DedeHai/RGBmatrix_6x6_Workshop/Photos/WS2812B_Detail.jpg

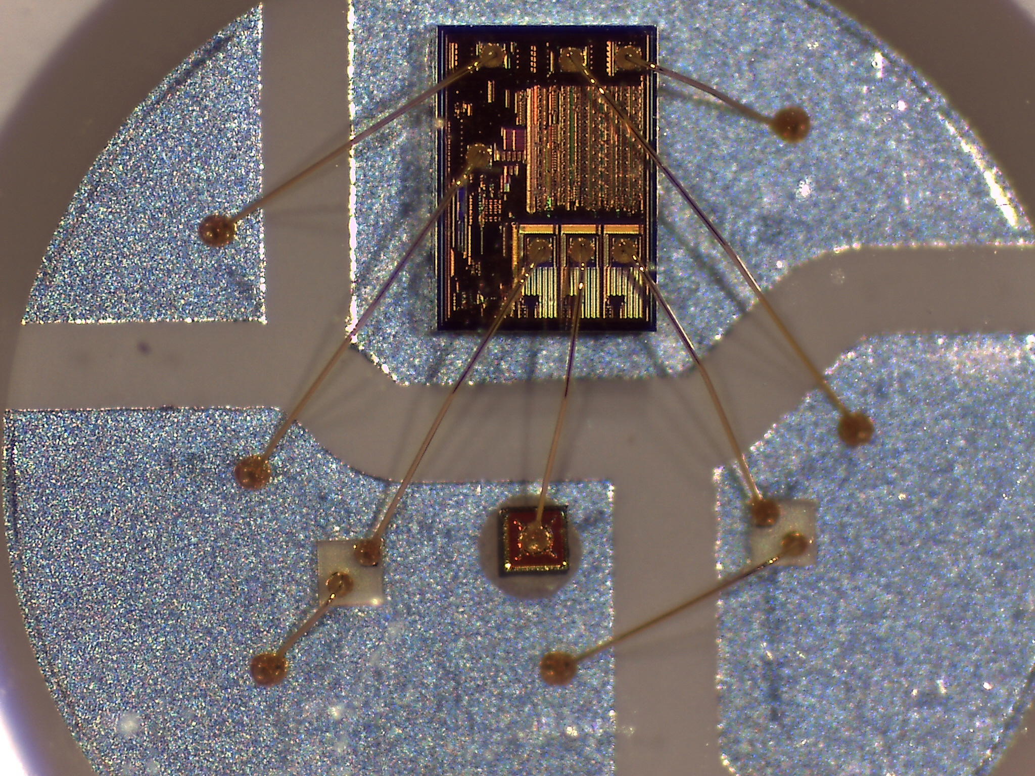
Photos/WS2812B_Detail.jpg
