DedeHai/RGBmatrix_6x6_Workshop/Photos/WS2812B_full.jpg

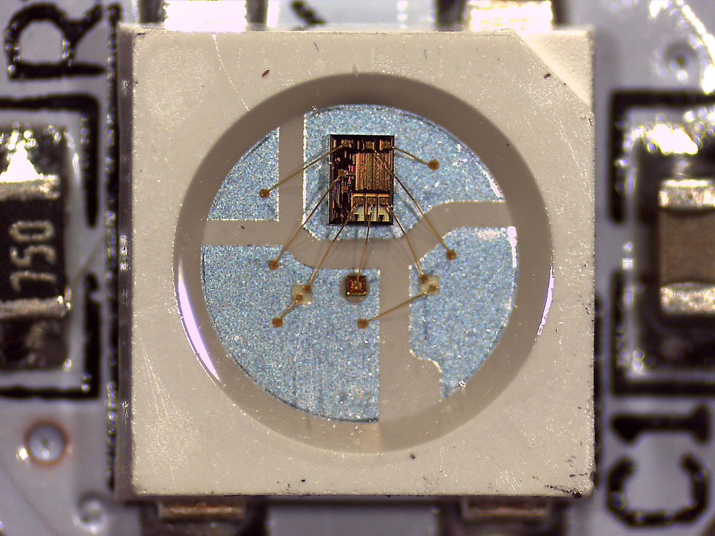
Photos/WS2812B_full.jpg
