DedeHai/RGBmatrix_6x6_Workshop/LED Panel Kurs Aufhänger mini.pdf

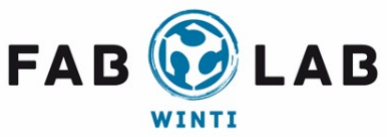
[picture p3: figure]

## Workshop: Bau von einer LED Matrix

Wir bieten dir in diesem Kurs die einmalige Gelegenheit ein LED Panel zu bauen, das von einem Arduino gesteuert wird. Diese moderne Lampe ist absolut einzigartig und ein garantierter Blickfang.
Auch für Anfänger geeignet.
Kosten inklusive 60.- Material: 195.- CHF/Person (Mitglieder 165.- CHF/Person) Anmelden unter www.fablabwinti.ch
