DedeHai/RGBmatrix_6x6_Workshop/LED Panel Workshop Anleitung.pdf

LED Panel Workshop Anleitung | Fablab Winterthur | Damian Schneider, 19. 4. 2015

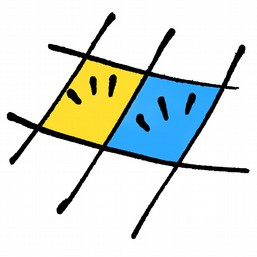
[picture p4: figure]

LED Panel Workshop - Bauanleitung

Materialliste
Netzteil: 5V 2A, Arduino Nano, Mini-USB Kabel, 2.1mm Steckerbuchse, Mikrofonmodul, RTC-modul, zwei Tasten, RIBBA Rahmen von Ikea, 36 LEDs (WS2812), Verbrauchsmaterial (Kabel, Pinheader, etc)
Raster vorbereiten
Nimm dir 14 Rasterleisten und schleife die Kanten der rauen Seite ganz leicht an, so dass sie etwas glatter wird. Manchmal sind die Kanten auch ohne schleifen schon OK. Steck die 14 Rasterleisten zusammen und lege es flach und rechtwinklig auf die Tischplatte. Was jetzt unten liegt wird nachher die Frontseite. Fixiere die Kreuzungen der Hauptdiagonalen sowie alle Kreuzungen auf der Aussenseite mit Weissleim. Nicht zu viel, wir wollen kein Leim der mehr als über die Mitte der Leisten nach unten läuft, das gibt sonst später ein Schatten im Bild. Leg das Raster zum trocknen zur Seite.

LED Platte vorbereiten

Zeichne mit einem Bleistift auf allen Seiten 14mm vom Rand der Platte eine Linie ein. Das ist das Aussenmass des Rasters.
Zeichne 6 senkrechte Linien, die erste mit 32mm Abstand zum Rand, die übrigen mit einem Abstand von jeweils 33mm voneinander (Tipp: die Rasterleisten sind im 33mm Abstand geschlitzt). Dasselbe nun in horizontaler Richtung.
Drehe die Platte so, dass die abgeschnittene Ecke Rechts unten liegt. Die sechs vertikalen Linien sind für die LED streifen. Markiere die Laufrichtung der LEDs mit Pfeilen, das erleichtert nachher das richtige Aufkleben. Zeichne unten bei der ersten Linie (die links) einen Pfeil nach oben, bei der zweiten nach unten, dritte nach oben usw.
Am oberen Ende: verbinde Linien 1&2 mit einem Bogen, dasselbe für 3&4 sowie 5&6. An diesen Stellen werden nachher Verbindungskabel gelötet.

Licensed under Creative Commons Attribution-NonCommercial-ShareAlike 4.0 International License

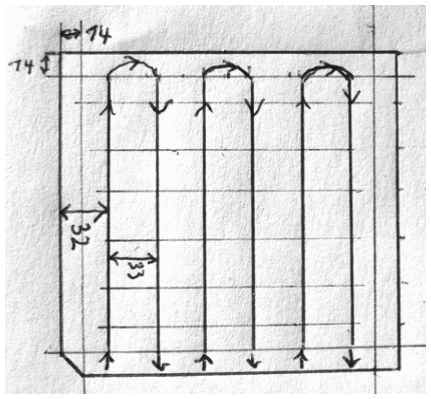
[picture p5: figure]

Zeit die LEDs aufzukleben.
Schneide mit dem Seitenschneider 6 LEDs vom Streifen ab. Markierte Schnittlinie benutzen. Lege (noch nicht kleben!) den streifen auf die Platte in korrekter Laufrichtung: die Pfeile auf der Platte müssen in dieselbe Richtung zeigen wie die Pfeile auf dem LED streifen. Mache das mit allen sechs Streifen. Prüfe nochmals die Laufrichtung. Schneide jetzt am unteren Ende der Streifen die Kupferaugen mittig durch (siehe Bild) Fixiere den Streifen ganz links und den ganz rechts ein- zwei Chläberli, so dass sie mit den geschnittenen Kupferaugen 1mm Abstand zur Linie haben.
Nimm den 'RGB strip link' (grünes PCB) und lege ihn so hin, dass er die beiden fixierten streifen verbindet (er muss UNTER den LED streifen liegen, mittig auf der eingezeichneten Linie). Richte die beiden LED streifen allenfalls nochmals aus, so dass die Lötstellen ganz genau aufeinander liegen.

Entferne das PCB, verstreiche auf der Unterseite
etwas Cementit, schieb es wieder zurück unter die LED streifen und drücke es etwas an damit es klebt. Eventuell auch noch mit etwas Scotch befestigen. Achtung: kein leim auf die Lötstellen, allenfalls reinigen.
Jetzt kannst du die restlichen Streifen auflegen und jeweils auch mit einem Chläberli fixieren. Achte auf genaue Ausrichtung der Lötaugen!
Bevor du jetzt die streifen Anlötest, kontrolliere nochmals die Laufrichtung der Streifen sowie die Ausrichtung der Lötaugen: es ist wichtig dass diese wirklich perfekt ausgerichtet sind, sonst entstehen
beim Löten Kurzschlüsse. Passt alles? Dann verlöte
alle 18 Verbindungen.

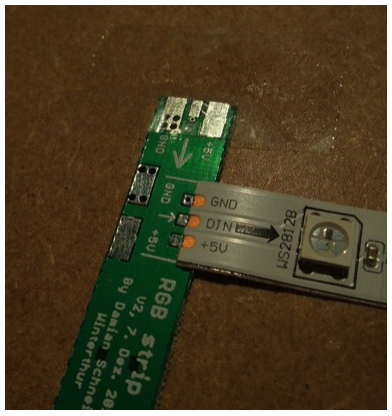
[picture p6: figure]

Es fehlen noch die Datenbrücken auf der oberen Seite, da wo die Bögen eingezeichnet sind. Verbinde jeweils DOUT mit DIN (die beiden mittleren Lötaugen). Verwende hierzu die vorbereiteten grünen Kabel, die sind bereits abisoliert und verzinnt.
Schnapp dir eine Steckbuchse für die Stromversorgung sowie 10cm vom roten und schwarzen Kabel (das etwas dickere, ohne Dupontstecker). Die Kabel beidseitig abisolieren: 1cm auf einer seite, 3mm auf der anderen. Steck die stärker abisolierten enden durch die Ösen der Buchse und verdrill es so, dass es etwas hält. Das rote Kabel muss mit dem mittleren Pin verbunden sein, das schwarze mit dem Seitenanschluss. Die etwas längere(nicht mit dem Steckergehäuse). Verlöte jetzt die beiden Kabel. Prüfe die Verbindung des roten Kabels mit dem Multimeter: Kurzschluss zwischen dem roten Kabelende und dem Pin in der Mitte der Buchse.
Löte die beiden Kabel am Eingang des 'Strip Link' PCBs, ganz links: schwarzes Kabel auf GND, rotes Kabel auf +5V.
Auf den nächsten beiden grossen Lötpads (GND und +5V) des PCBs kommen zwei Kabel mit Dupontsteckern: am besten ein rotes und ein schwarzes. Schneide die Kabel in der Mitte durch, Enden abisolieren, verzinnen und verlöten. Das ist die Stromversorgung fürs Arduino.
Es fehlt noch die Datenverbindung vom Arduino zu den LEDs: wie für die Stromversorgung, halbiere ein Kabel und verlöte es mit dem mittleren Pad (DIN) des ersten LED-Streifens, gleich neben den beiden Kabeln die du grad eben angelötet hast. Ok fertig. Vor dem aufkleben des Rasters (oder dem ersten Test) unbedingt mit dem Multimeter prüfen:
- Alle GND der Streifen zu GND vom grünen PCB: Kurzschluss (<5 )
- Alle +5V der streifen zum 5V vom PCB: Kurzschluss.
- 5V und GND: KEIN Kurzschluss (>10k )
- DIN und DOUT: KEIN Kurzschluss zu 5V sowie GND (bei der Lötstelle von jedem streifen messen)
Jetzt ist die LED Platte fertig. Wenn du dir nicht ganz sicher bist, dass alles stimmt solltest du dein Werk zum Testen vorbeibringen. Nachdem das Raster aufgeklebt ist sind Korrekturen unmöglich ohne das Raster wieder wegzureissen.

Raster aufkleben

Leg das Raster auf die Platte. Passt es auf die eingezeichneten Linien und die LEDs sind jeweils in der Mitte eines Feldes? Es liegt einigermassen flach auf und der Spalt zwischen Raster und Platte ist kleiner als 3mm? Dann ist alles tip top. Drücke es etwas fest und fixiere es aussen an allen vier Ecken mit Heissleim. Achte darauf, dass du das Raster nicht verziehst oder einzelne Leisten nach unten drückst, der Leim ist noch nicht ganz trocken.
Wenn der Heissleim etwas ausgekühlt ist, prüfe ob alles sauber sitzt. Mit ca. 10 Tupfern Weissleim hält das Raster später auch richtig gut. Füge diese an Verschiedenen Stellen über das Raster verteilt hinzu, mehr sind nicht nötig, es erschwert nur eine allfällige Reparatur.
Prüfe: ist das Raster Frontseitig absolut flach und sauber?
Arduino Löten

Bis auf drei Verbindungen zum Mikrofonmodul werde alle Leitungen direkt am Arduino eingesteckt. Wichtig ist, dass das Arduino inkl. Stecker nachher seitlich in den Rahmen passt. Dazu werden die gebogenen Pins nach innen und nicht nach aussen gerichtet angelötet (siehe Bild). Ausserdem müssen die beiden Pins von GND und 5V leicht verdreht werden da sie einander genau gegenüber liegen. Man kann die Pins auch nach dem Löten noch etwas biegen. Löte die Pins genau wie auf dem Foto:
4 pins von D7 bis D10, zwei auf A4 & A5, zwei auf VIN und den GND daneben so wie je einer in den zweiten GND und 5V gegenüber.
Fürs Mikrofonmodul braucht's drei Kabel mit Dupont Stecker auf einer Seite: drei Dupont-Kabel zerschneiden, abisolieren und auf A0, A1 und A2 einlöten. A0 ist der Signaleingang, A1 und A2 wird zur zur Stromversorgung des Moduls verwendet.

Verbinde das RTC-Modul (real time clock, zu Deutsch: die Echtzeituhr) mit dem Arduino. Dazu braucht es vier Dupont-Kabel, beidseitig mit Stecker. Verbinde das Modul gemäss Tabelle.

Arduino Pin | Funktion (verbunden mit)
D7 | DIN (LED Dateneingang)
D8 | Primäre Taste (Button1)
D9 | Sekunädre Taste (Button2)
D10 | Ground für Knöpfe
A0 | 'S' (signal) vom Mikrofonmodul
A1 | '+' vom Mikrofonmodul (+5V)
A2 | '-' vom Mikrofonmodul (GND)
A4 | SDA vom RTC-Modul
A5 | SCL vom RTC-Modul
GND | GND vom RTC-Modul
5V | VCC vom RTC-Modul
VIN | +5V vom 'strip link'
GND | GND vom 'strip link'

Tasten löten

Die beiden Funktionstasten haben je vier Beinchen. Biege diese nach innen, sodass sich jeweils die beiden gegenüberliegenden berühren. Zerschneide drei Dupont-Kabel (nicht zu kurz) und löte zwei davon an den selben Knopf und das dritte an den zweiten. Verbinde den noch freien Anschluss des zweite Knopfs mit einem der Anschlüsse des ersten. Dieser wird nachher mit Masse (GND) verbunden. Benutz am einfachsten eines der vorbereiteten grünen Kabel für die Brückenverbindung.

Rahmen Vorbereiten

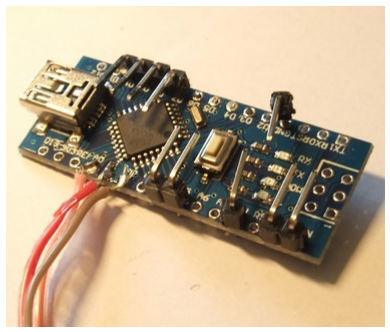
[picture p7: figure]
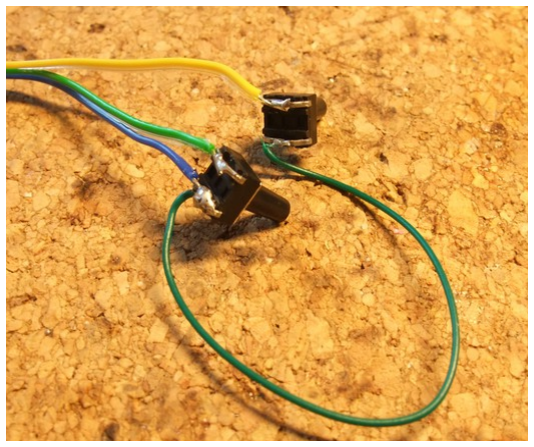
[picture p8: figure]

Im Rahmen braucht es drei Löcher: zwei für die Tasten und eins für die Steckerbuchse. Wo du welche Löcher platzierst ist völlig frei, eventuell musst du aber die Kabel verlängern. Überleg wo es sinn macht: wenn du das Panel aufhängen willst ist es besser den Stromanschluss unten zu machen und die Tasten auf der Seite, wenn du es aufstellen willst ist der Stromanschluss besser auf der rechten oder linken Seite. Zeichne mit Bleistift ein kleines Kreuz, da wo du die Löcher bohren willst.
Für die Buchse:
Bohre ein 8mm Loch von aussen. Damit die Buchse von innen ins Loch passt muss es innen 12mm Durchmesser haben, also mit dem 12mm vorsichtig aufbohren. Testen ob die Buchse passt (Buchse ohne Kabel nehmen) und vorne die Mutter aufgeschraubt werden kann. Die Unterlagsscheibe ist nicht zwingend nötig.
Für die Tasten:
bohre die löcher von aussen nach innen, 4mm, nicht mehr als 4cm abstand voneinander. Um die Tasten innen zu versenken, bohre mit einem 8mm Bohrer innen das loch etwas aus. Nicht zu tief bohren aber tief genug damit die taste aussen aus dem Loch rausschaut (ca 4-5mm tief). Klebe die beiden Tasten mit Cementit fest. Stecke sie dazu zuerst ins Loch und gib den Kleber drauf. Achtung: zuviel Kleber kann den Taster zukleben und blockieren.
Zusammenbau

Schneide die Diffusorfolie auf die Grösse der Scheibe zu (besser 1-2mm kleiner) mit Cutter oder Schere. Achtung: die Folie nicht knicken! Reinige die Glasscheibe und leg sie in den Rahmen. Leg die Diffusorfolie darauf.
Leg die fertige Rasterplatte neben den Rahmen und schliesse alle Kabel gemäss Tabelle ans Arduino. Platziere die Elektronik und Kabel so, dass nichts über die Grundplatte hinausragt (pins eventuell etwas biegen). Fixiere die Module und die Kabel gegebenenfalls mit ein bisschen Heissleim. Schraube die Buchse in den Rahmen. Versenke nun vorsichtig die Rasterplatte im Rahmen, ohne dass die Kabel zwischen Raster und Folie eingeklemmt werden.
Das war's!
