DedeHai/RGBmatrix_6x6_Workshop/RGB-strip-connector-v2.brd

## EAGLE design RGB-strip-connector-v2.brd (2015-04-11)

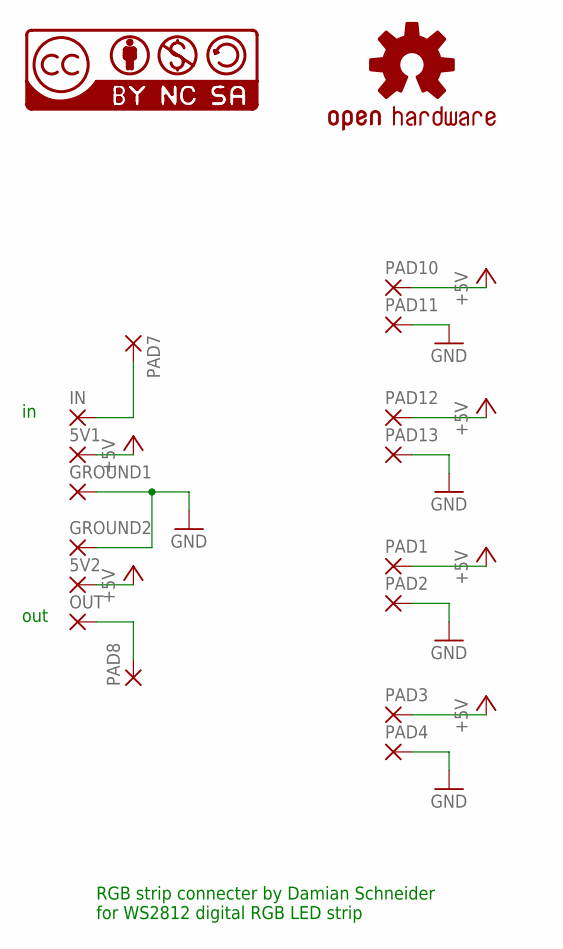
[picture p9: schematic RGB-strip-connector-v2.sch]

Parts:
5V1, 5V2: SMD2; SMD1,27-2,54
GROUND1, GROUND2: SMD2; SMD1,27-2,54
IN: SMD2; SMD1,27-2,54
LOGO1: OSHW-LOGOL; OSHW-LOGO-L
OUT: SMD2; SMD1,27-2,54
PAD1, PAD2, PAD3, PAD4, PAD10, PAD11, PAD12, PAD13: SMD5; SMD2,54-5,08
PAD7, PAD8: SMD2; SMD1,27-2,54
U$1: CC-NC-BCNIX; CC-NC-B_NIX

Connections:
+5V: 5V1.1, 5V2.1, PAD1.1, PAD3.1, PAD10.1, PAD12.1
GND: GROUND1.1, GROUND2.1, PAD2.1, PAD4.1, PAD11.1, PAD13.1
unnamed: OUT.1, PAD8.1
unnamed: IN.1, PAD7.1

Notes on the sheet:
out
RGB strip connecter by Damian Schneider for WS2812 digital RGB LED strip

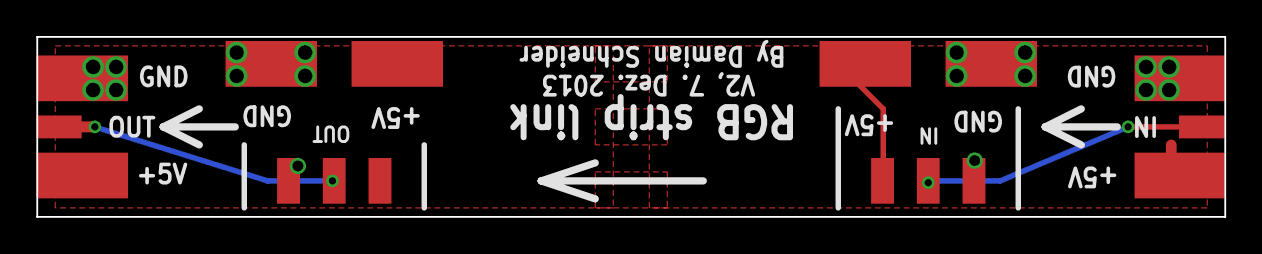
[picture p10: board RGB-strip-connector-v2.brd from above]

Board: 2 copper layers, 66.0 x 10.0 mm, 18 parts (1 on the bottom side), 4 nets.
