DedeHai/RGBmatrix_6x6_Workshop/(commit log)

2015-04-11 Initial Release
    [RGB-strip-connector-v2.brd, RGB-strip-connector-v2.sch]
2016-03-18 added svg laser file
