DedeHai/RGBmatrix_6x6_Workshop/(notices)

Notices in the files:
Arduino/Additional Libraries/RGBpixelmatrix/RGBpixelmatrix.cpp:
This program is free software: you can redistribute it and/or modify it under
the terms of the GNU General Public License as published by the Free Software
parts and their libraries:
SparkFun-Aesthetics: Licensing: Creative Commons ShareAlike 4.0 International - https://creativecommons.org/licenses/by-sa/4.0
cc-by-nc-sa: All hardware is licensed under the Creative Commons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
